the-phycopath/aero-uh/DBF 2025-26/tables for proposal.xlsx

Sheet: trade study template
 |  | Score goes here
Criteria | Weighting Factor | Option A | Option B | Option C | IMAGES if possible
Stability | 3 | 6
Cost | 4 | 7
Complexity | 5 | 9
etc ctc. | 7 | 4
Total Score |  | 119

Sheet: subteams
Sub-Teams | Roles | Skill Sets
Aerodynamics | Designs, analyzes, and manufacture wings, empennage, and control surfaces. | Aerodynamic Analysis (XFLR5), CFD, CAD, Manufacturing
Avionics | Determines and applies all electrical and signal components in the aircraft | Soldering, Circuitry, CAD
Structures | Designs & analyzes fuselage, landing gear, and other physical aspects of the aircraft | CAD, CAM, Structural Analysis, Manufacturing
Banner Systems

Sheet: budget
BUDGET
Avionics |  | Structures / Banner Systems |  | Logistics
Component | Price | Component | Price | Component | Price
Receiver | $130 | Basswood Sheets | $50 | Entrance Fee | $550.00
Servos (x7) | $87 | CF Rod | $70 | Transportation
Motor | $139 | Landing Gear | $50 | Lodging
Battery | $85 | Balsawood Sheets | $50 | Shipping
Transmitter | $320 | Filament |  | Misc
Propeller | $67 | Hinges etc. |  | Food
ESC | $125 | Monokote
Wiring | $30 | Banner material
Misc | $40 | Fishing wire
Total Cost | $1023 | Total Cost | $220 | Total Cost | $550
Total Project Cost |  |  |  |  | $1793
 |  | needs more info

Sheet: Gantt
SC-AERO 25-26 Schedule | September |  |  |  | October |  |  |  | November |  |  |  | December |  |  |  | January |  |  |  | February |  |  |  | March |  |  |  | April
 | 1 | 2 | 3 | 4 | 1 | 2 | 3 | 4 | 1 | 2 | 3 | 4 | 1 | 2 | 3 | 4 | 1 | 2 | 3 | 4 | 1 | 2 | 3 | 4 | 1 | 2 | 3 | 4 | 1 | 2 | 3 | 4
Aircraft Design
Rules Review | h
Conceptual Design
Sensitivity Analysis
Detailed Prototype 1 Design
Final Design
Manufacturing
Prototype 1 Manufacturing
Electronics Assembly
Fuselage Manufacturing
Wings Manufacturing
Empennage Manufacturing
Payload Bay Manufacturing
Banner Deployment System Manufacturing
Final Plane Manufacturing
Electronics Integration
Fuselage Manufacturing
Wings Manufacturing
Empennage Manufacturing
Payload Bay Manufacturing
Banner Deployment System Manufacturing
Final Plane Integration
Testing & Validation
Ground Tests
Banner Wind Tunnel Testing
Battery Limit Testing (Flight time test)
Thrust Test
Simulations (FEA & CFD)
Wing Loading Test
Banner Deployment & Release Test
CG Test
Flight Tests
Ground Mission Test
Mission 1 Test
Mission 2 Test
Mission 3 Test
Final Flight Test
Pre-Tech Inspection Test
Competition Deliverables
Proposal
PDR
Design Report
CDR
Competition

Sheet: mission scoring
 | formula goes here
Mission | Scoring Criteria | Mission Description | Subsystem Requirements
Mission 1 | #VALUE!
Mission 2 | #VALUE!
Mission 3 | #VALUE!
Ground Mission | #VALUE!

Sheet: Sheet2
Test Type |  | Objective | Method | Sub-Team
Propulsion test | Thrust Test Stand |  |  | Avionics
 | Battery Drain Test |  |  | Avionics
Ground Test | Wing Loading Test
 | Electronics Bench Test |  |  | Avionics
 | Banner Drag Test
Flight Tests | Prototype #1
 | Prototype #2
 | Control's test
