the-phycopath/aero-uh/(list of files, cad)

Other CAD files:
DBF 2024-25/AIAA Test 2.ipt
DBF 2024-25/Fuselage.ipt
DBF 2024-25/Fuselage_Abbott.ipt
DBF 2024-25/Fuselage_v2.ipt
DBF 2024-25/Fuselage_v3.ipt
DBF 2024-25/Fuselage_v3_2.ipt
DBF 2024-25/OldVersions/Fuselage_Abbott.0038.ipt
DBF 2024-25/OldVersions/Fuselage_v3_2.0002.ipt
DBF 2024-25/OldVersions/Reference_Fuselage.0005.ipt
DBF 2024-25/OldVersions/Reference_Fuselage.0006.ipt
DBF 2024-25/Part1.ipt
DBF 2024-25/Part2.ipt
DBF 2024-25/Reference_Fuselage.ipt
DBF 2025-26/Duck_Holder.ipt
